MakeMagazinDE/Smart-Dimmer/iot_dimmer_v02_silk_bottom.pdf

U3

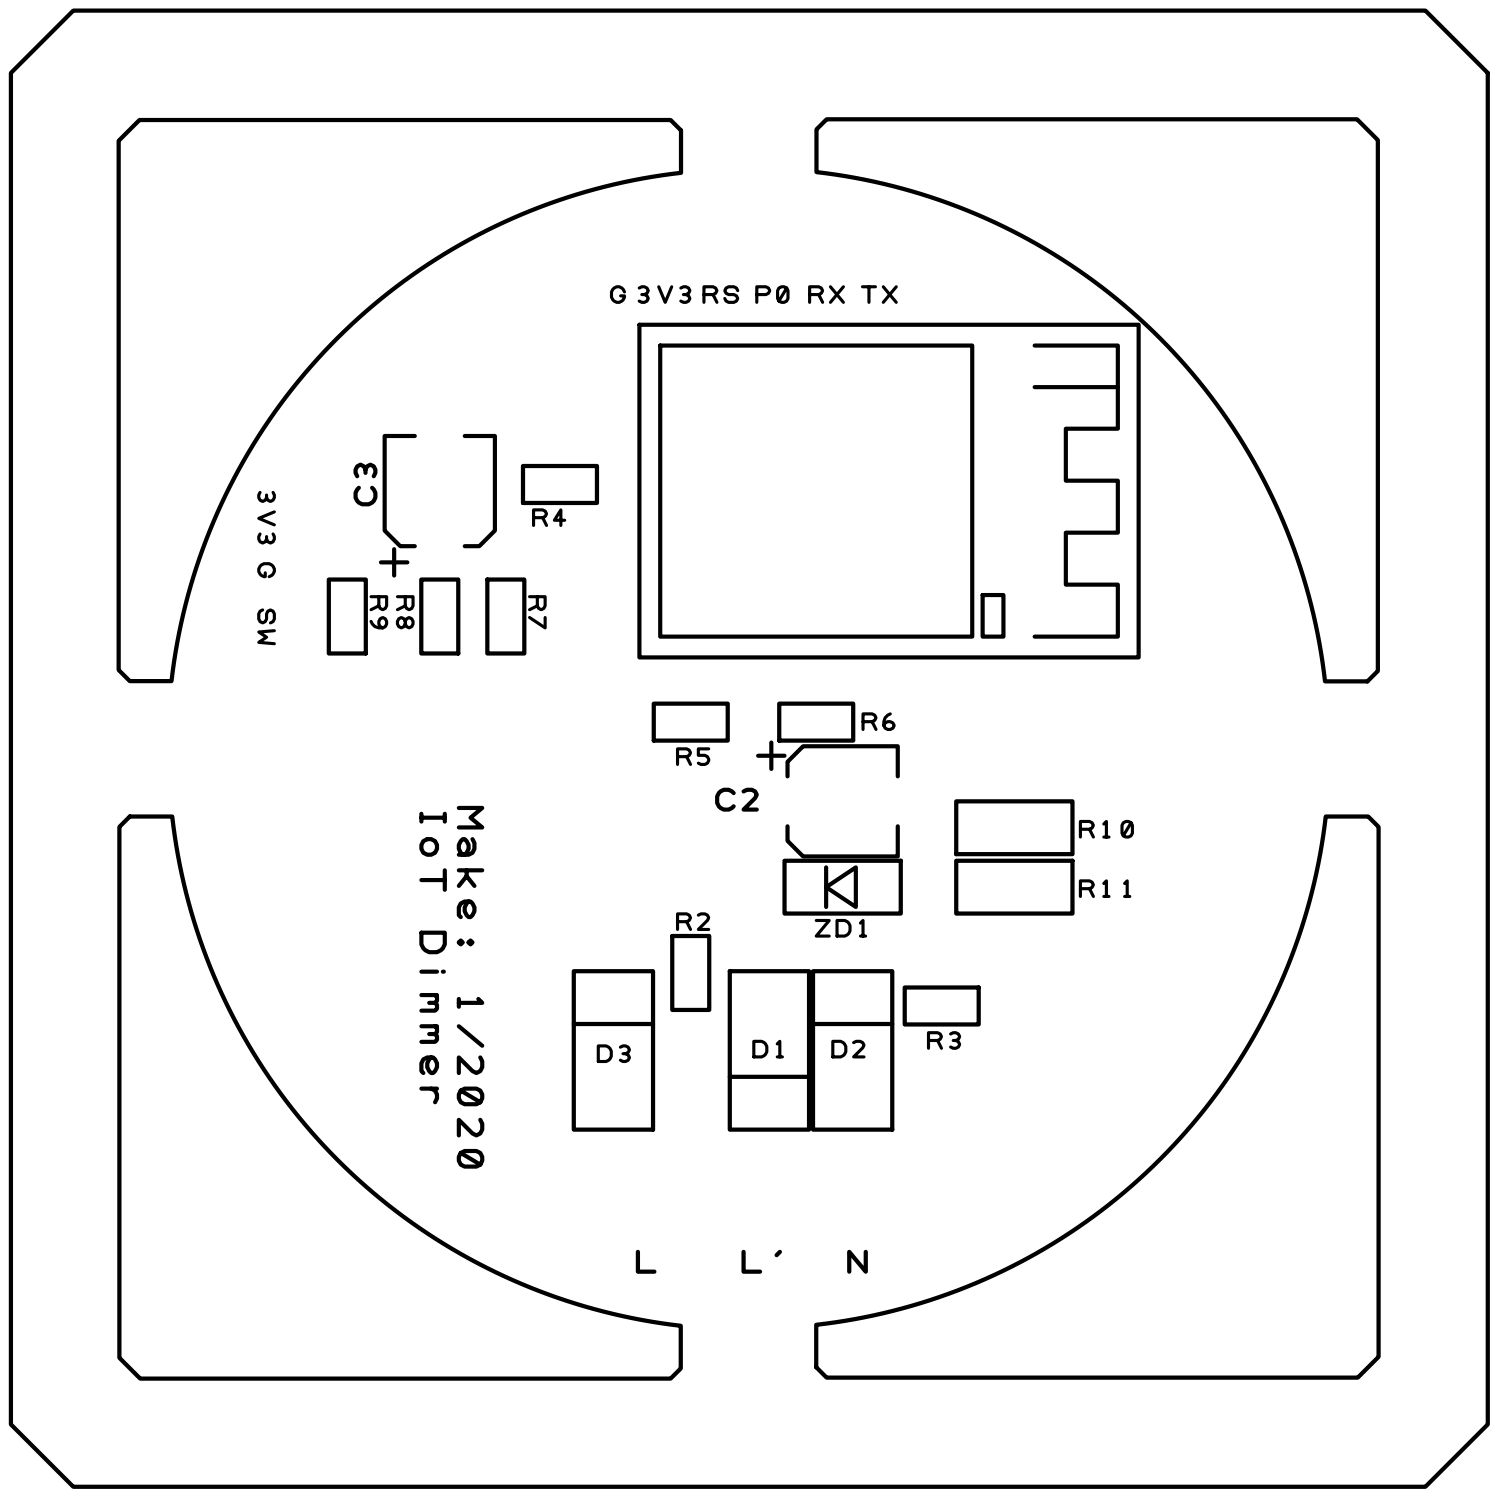
[picture p3: page 1]
