MakeMagazinDE/Smart-Dimmer/iot_dimmer_v02_silk_top.pdf

PL1
TR1

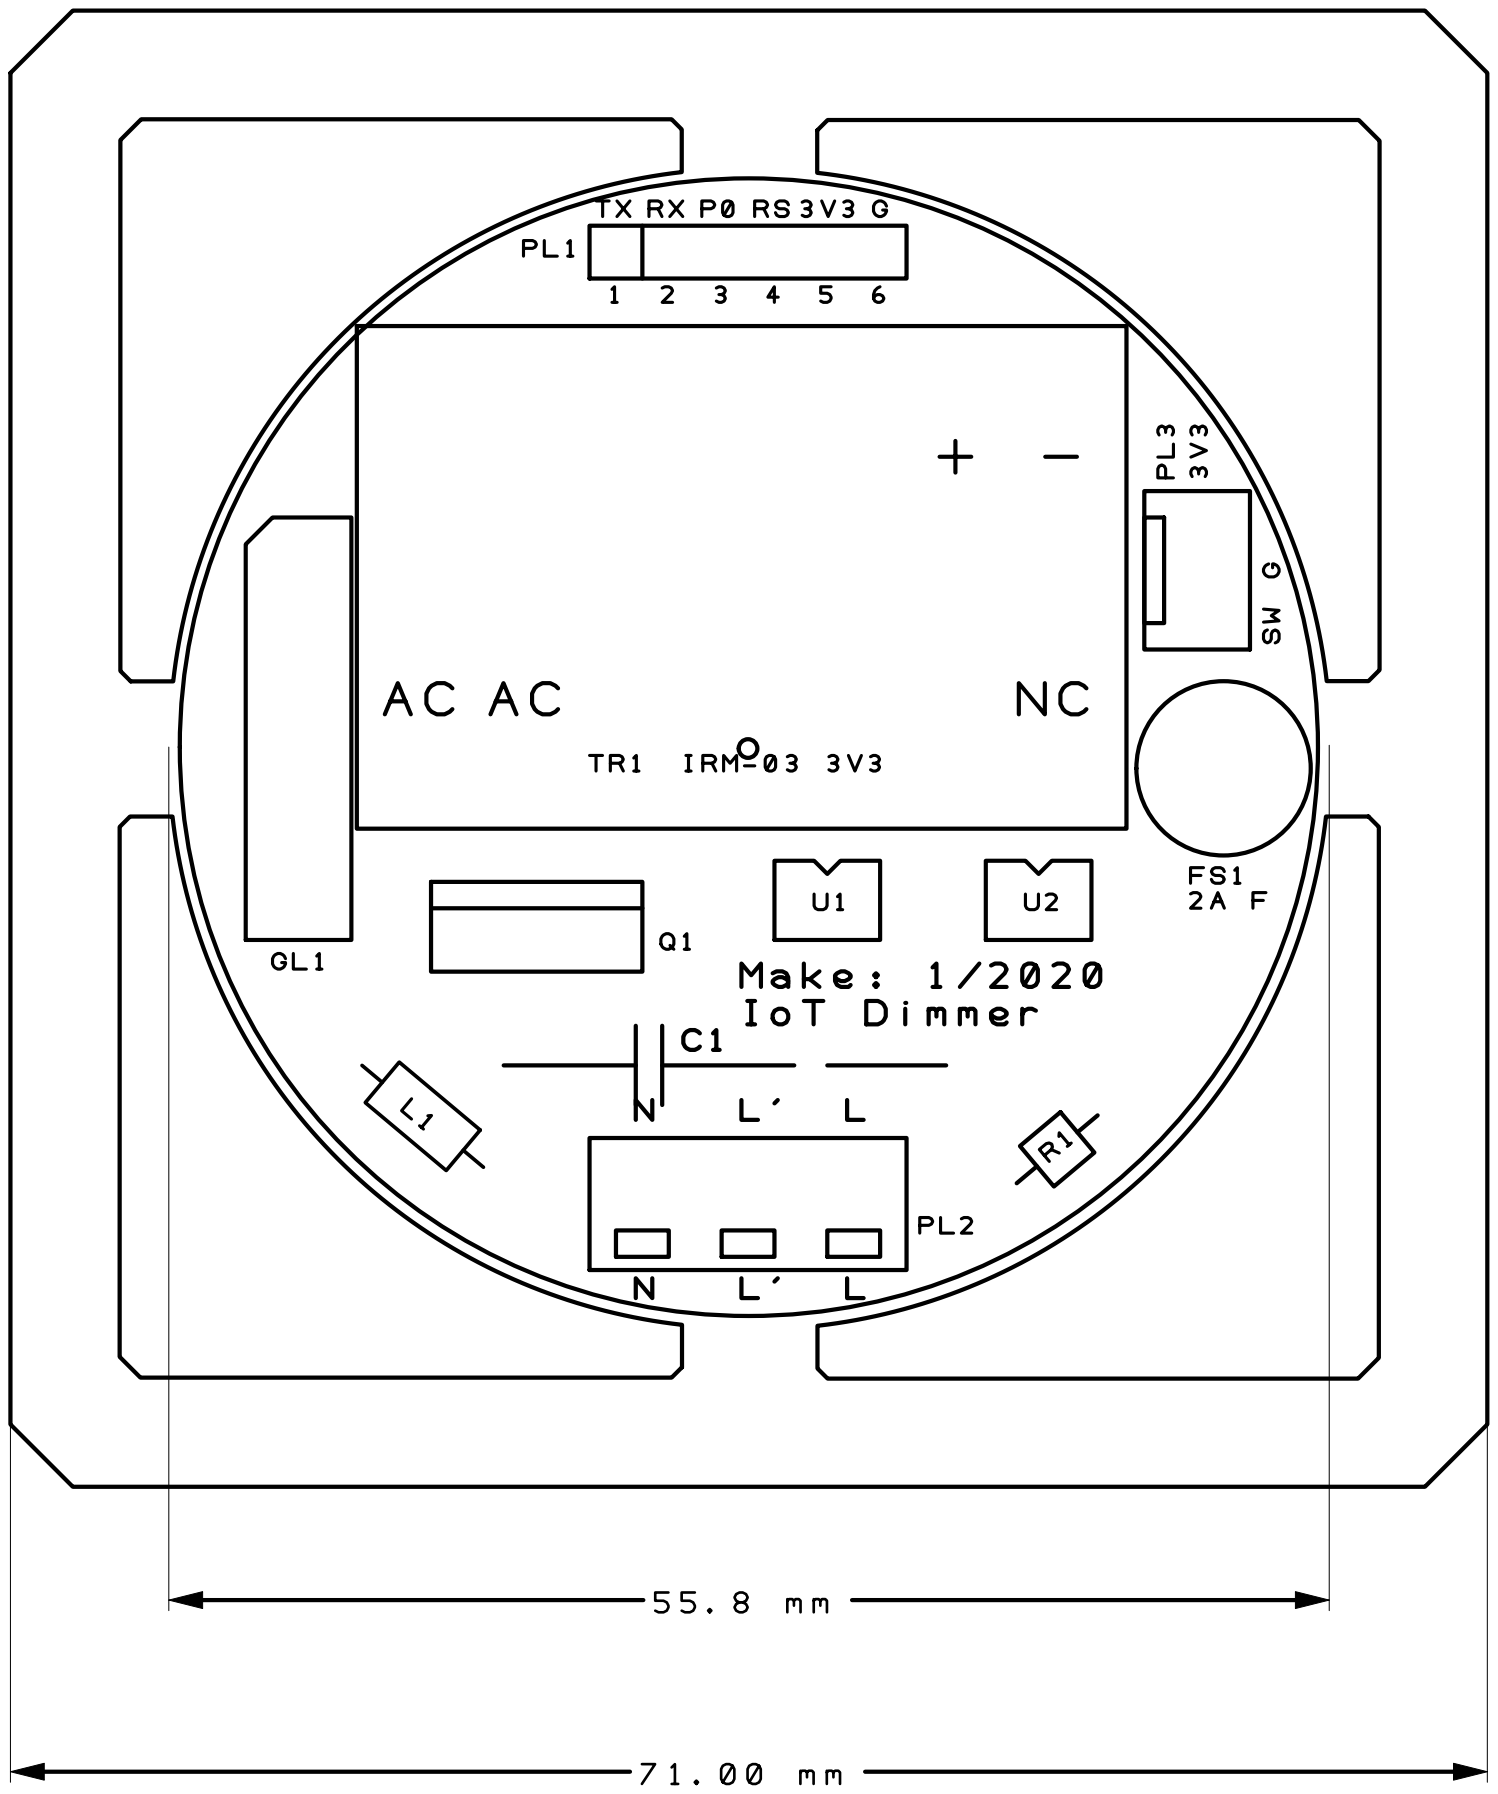
[picture p4: page 1]
