MakeMagazinDE/Smart-Dimmer/(threads)

Thread 1 (2020-03-02):

Gerber-Lage Top Copper gegenüber den anderen Lagen verschoben

papamidas, 2020-03-02:
Hi,
mein Gerber-Viewer zeigt mir, dass die obere Kupferlage in der Gerber-Datei
iot_dimmer_v02 - Top Copper.gbr
gegenüber den anderen Lagen vertikal um 3,8 mm nach unten verschoben ist.

gdampf, 2020-03-14:
Ich habe  die Gerber-Dateien, so, wie sie sind an JLCPCB geschickt und inzwischen einwandfreie Platinen erhalten - nix ist verschoben.
Also entweder ist der Gerber-Viewer von papamidas Schrott, oder die Chinesen sind (trotz Corona) so nett und haben den Fehler korrigiert. Ich glaube aber eher an ersteres.

papamidas, 2020-03-18:
Hallo gdampf, ich habe die Gerber-Dateien ebenfalls unverändert an JLCPCB geschickt und einwandfreie Platinen erhalten.
Als Gerber-Viewer hab ich den von KICAD 5.1.4 verwendet; der ist nach meiner Erfahrung eigentlich kein Schrott! Könnten also doch evtl. nette Chinesen im Spiel gewesen sein.

Closed 2020-03-18.

Thread 2 (2020-03-25):

Dead Code

gdampf, 2020-03-25:
Line 201-205 ist toter Code!
Die in Line 203 deklarierte Variabel ti-n2 hat außerhalb des if-Statements keine Gültigkeit und verändert die in Zeile 200 deklarierte Variabel ti-n2 nicht in ihrem Wert.
Was will der Autor uns also damit sagen?

gdampf, 2020-03-26:
Und wozu dient die Variabel last_connection?
Die kann nie einen anderen Wert als 0 haben. Dann wird aber der Reconnect viel zu häufig versucht. Oder verstehe ich da etwas falsch?

gdampf, 2020-03-28:
Was meint eigentlich die Zeile
pinMode(an_oder_abschnitt,INPUT_PULLUP);
Da an_oder_abschnitt vom Typ Boolean ist, kann dies nur ein Überbleibsel aus einer Phase sein, in der der Autor noch einen PIN dafür verwenden wollte, zwischen Phasenanschnitt und Phasenabschnitt zu wechseln.
Jetzt ist das nur noch Code-Müll, der nur deshalb nicht zu Fehlern führt, weil C so lässig ist.
Tatsächlich wird hier - abhängig von den Einstellungen mal der PIN GPIO0 und mal der PIN GPIO1 auf Eingang geschaltet - ohne jeden Sinn!

Thread 3 (2020-04-25):

Versatz im Kupfer Top Layer

leon2225, 2020-04-25:
Guten Abend,
wie in der angegfügten Grafik zu erkennen, scheint das Kupfer Toplayer einen Y-Versatz aufzuweisen.
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
Wäre es möglich diesen zu entfernen?

MakeMagazinDE, 2020-04-27:
Ist behoben. neue Gerber-Files hochgeladen.

Thread 4 (2020-05-13):

R5 & R7 fehlen in Stückliste

Torsten-, 2020-05-13:
Hi,

habe die Platine und alle Teile nach Stückliste bestellt. Jetzt sind R5 und R7 auf der Platine noch frei. Laut Schaltplan werden die aber zwingend benötigt. Werde dann wohl THT-Widerstände auf die Platine pfuschen, da ich kein SMD vorrätig habe.
Wäre cool wenn ihr die Stückliste korrigiert.

Gruß
  Torsten
